bruceboge/EnviroSat/docs/raspi-image.png

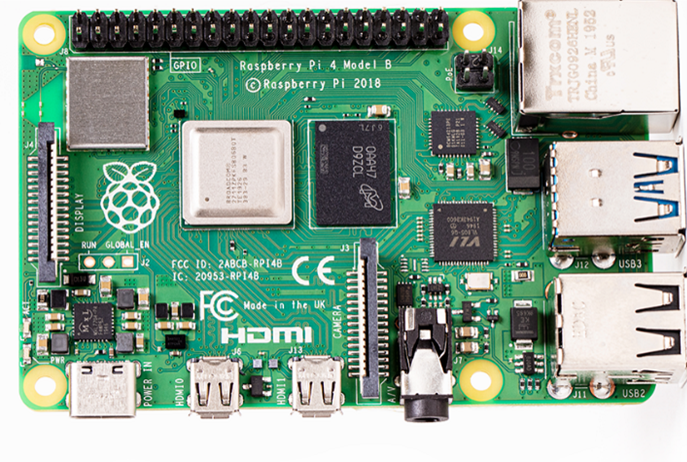
docs/raspi-image.png
