bruceboge/EnviroSat/Images/Board 2(3).png

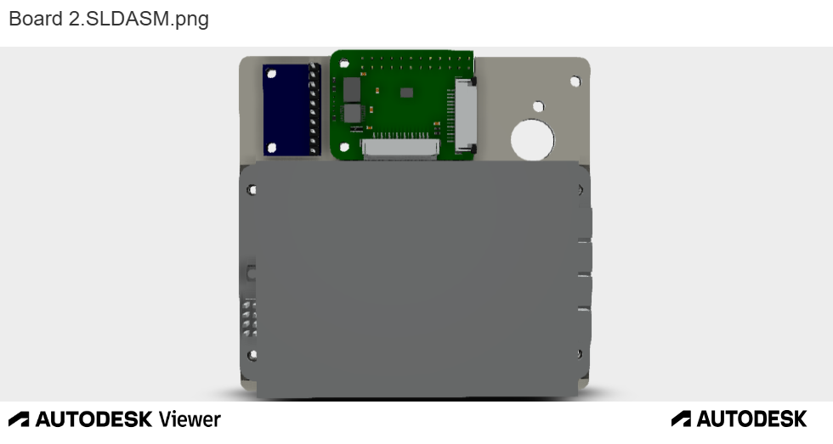
Images/Board 2(3).png
