bruceboge/EnviroSat/Images/Board 2.png

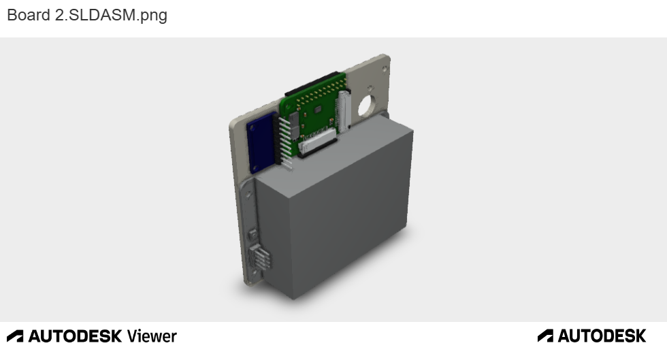
Images/Board 2.png
