bruceboge/EnviroSat/Images/Board 3.png

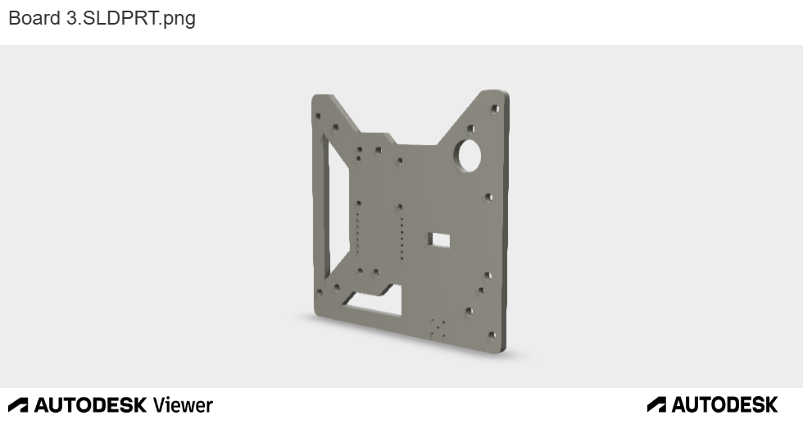
Images/Board 3.png
