bruceboge/EnviroSat/Images/powersystem.drawio.png

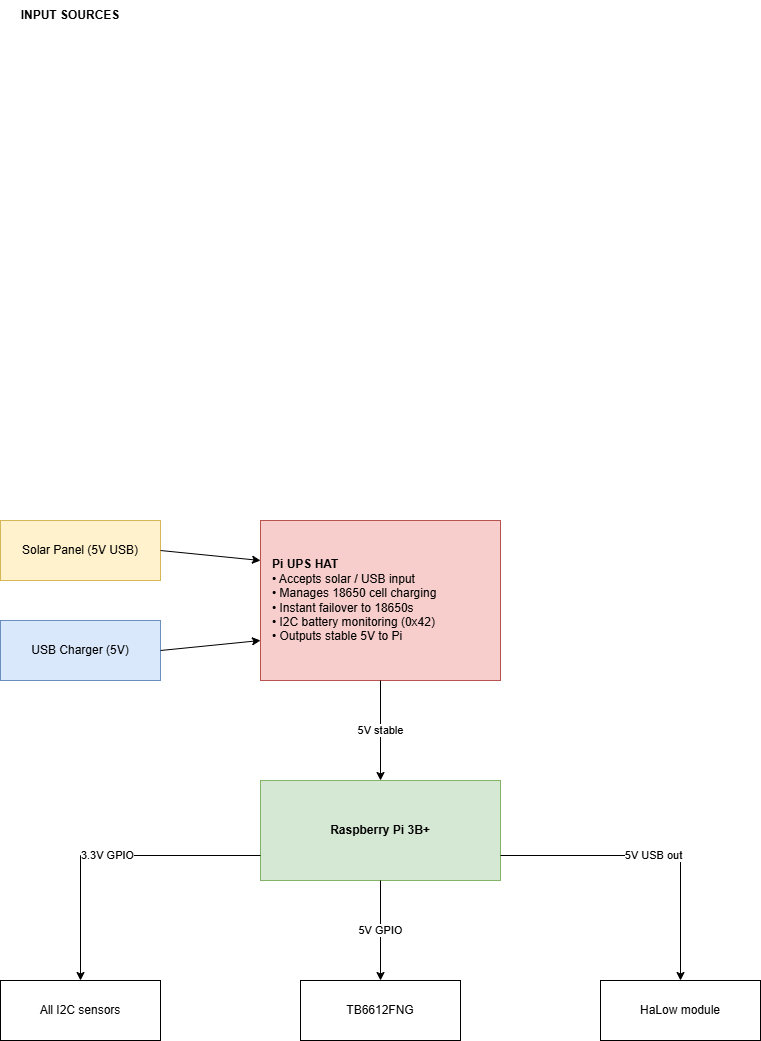
Images/powersystem.drawio.png
