bruceboge/EnviroSat/Images/Side Camera_Frame 2.png

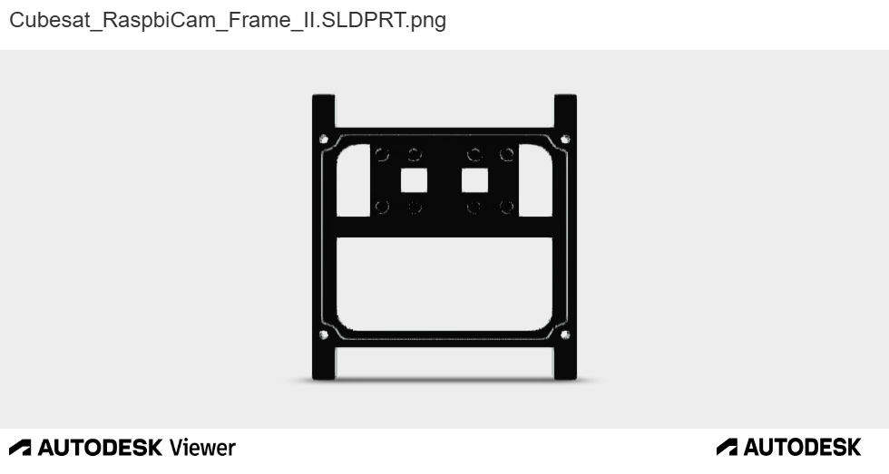
Images/Side Camera_Frame 2.png
