bruceboge/EnviroSat/Images/Side_Frame_Plain.png

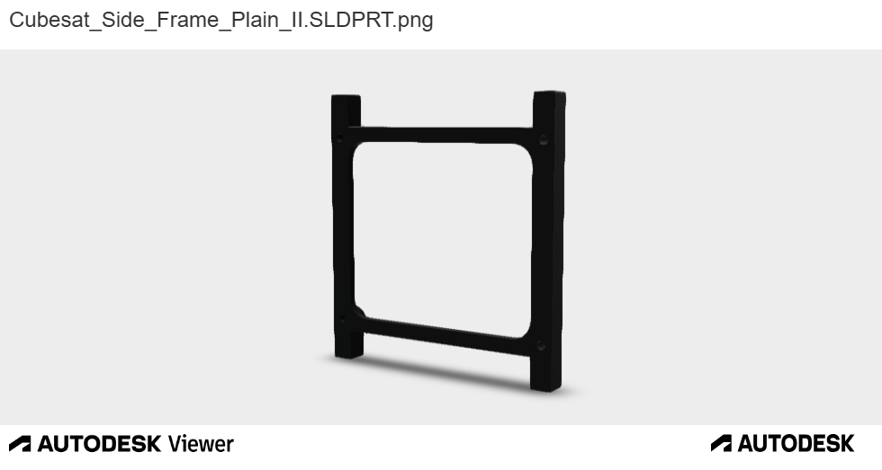
Images/Side_Frame_Plain.png
