bruceboge/EnviroSat/Images/Top_Frame.png

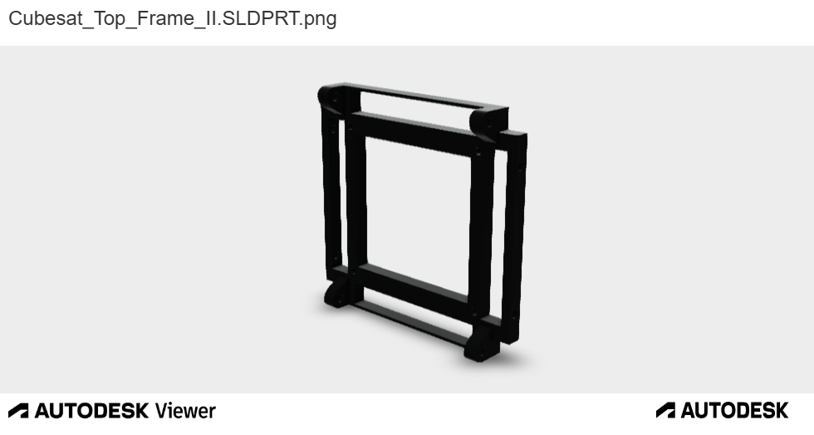
Images/Top_Frame.png
