bruceboge/EnviroSat/structure/Assembly/Cubesat.SLDASM

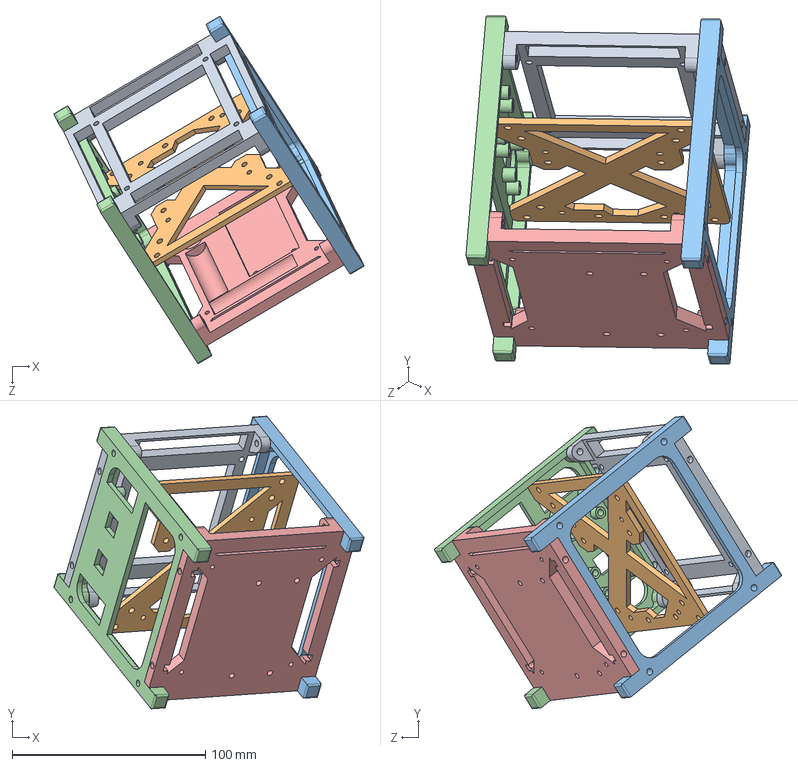
[picture p31: CAD file, 2026-03-10]
structure/Assembly/Cubesat.SLDASM
160.4 x 151.4 x 179.6 mm
Cubesat_Bottom_Frame_II
Cubesat_RaspbiCam_Frame_II
Cubesat_Side_Frame_Plain_II
Cubesat_Adaptor_Mount_II
Cubesat_Top_Frame_II
