bruceboge/EnviroSat/structure/3D Design Files/Modified_Cubesat_RaspbiCam Dual_Camera_Frame.stl

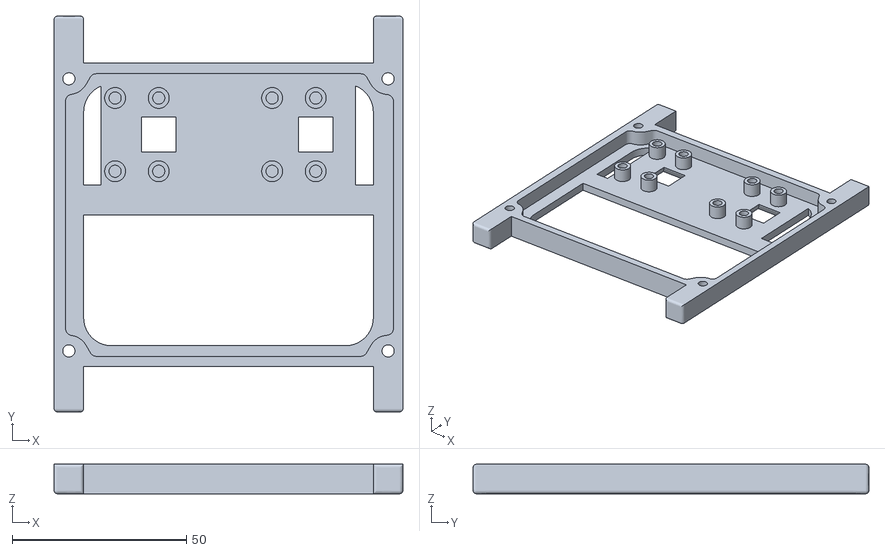
[picture p32: CAD file, 2026-03-10]
structure/3D Design Files/Modified_Cubesat_RaspbiCam Dual_Camera_Frame.stl
100.0 x 113.5 x 8.50
