bruceboge/EnviroSat/structure/3D Design Files/Cubesat_Adaptor_Mount.stl

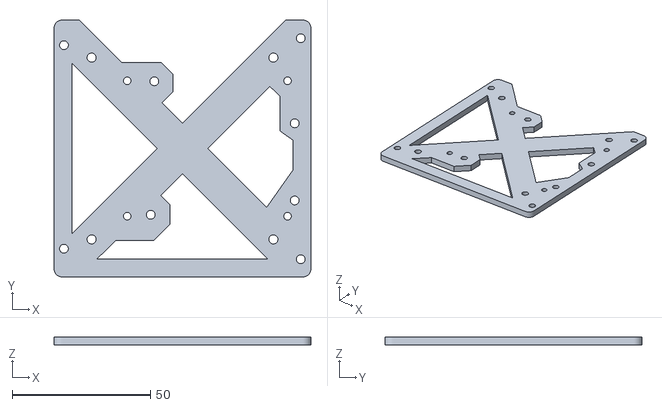
[picture p33: CAD file, 2026-03-10]
structure/3D Design Files/Cubesat_Adaptor_Mount.stl
93.0 x 93.0 x 3.00
