bruceboge/EnviroSat/structure/Assembly/Board 3.SLDPRT

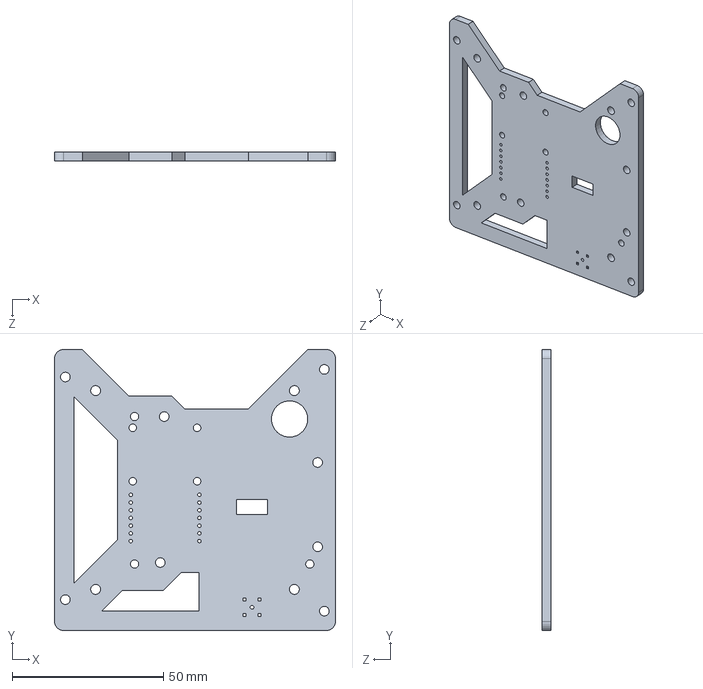
[picture p34: CAD file, 2026-03-10]
structure/Assembly/Board 3.SLDPRT
93.0 x 93.0 x 3.00 mm
