bruceboge/EnviroSat/structure/3D Design Files/Cubesat_Side_Frame_Plain.stl

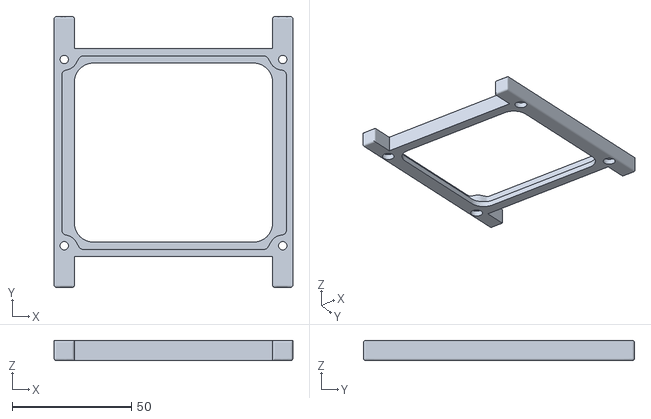
[picture p35: CAD file, 2026-03-10]
structure/3D Design Files/Cubesat_Side_Frame_Plain.stl
100.0 x 113.5 x 8.50
