bruceboge/EnviroSat/structure/Assembly/Arducam Multi Cam.SLDPRT

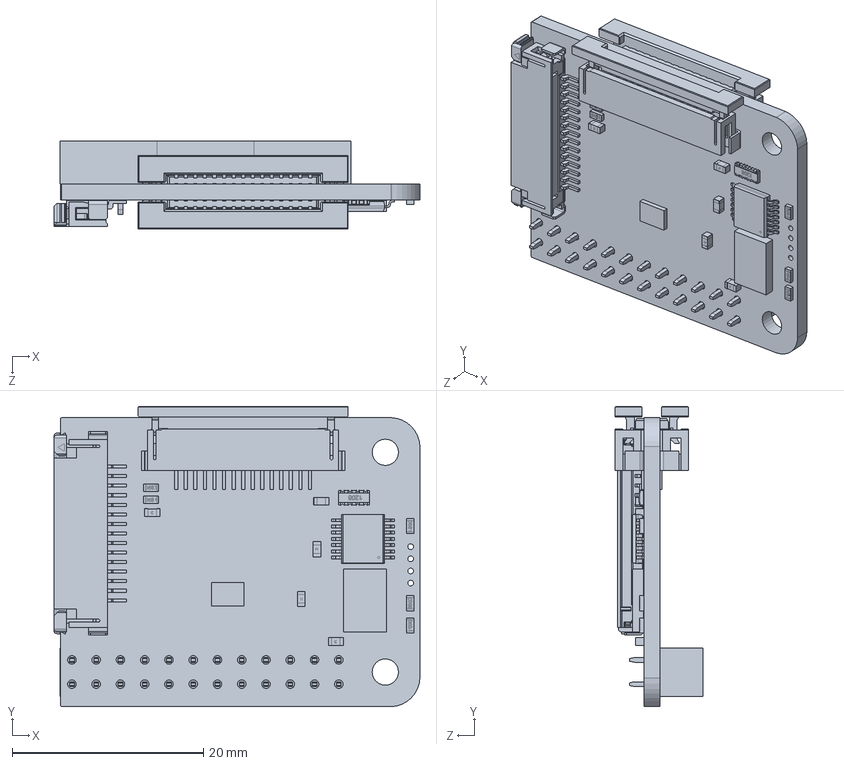
[picture p36: CAD file, 2026-03-10]
structure/Assembly/Arducam Multi Cam.SLDPRT
38.3 x 31.4 x 9.16 mm
