bruceboge/EnviroSat/structure/3D Design Files/Original_Cubesat_RaspbiCam_Frame.stl

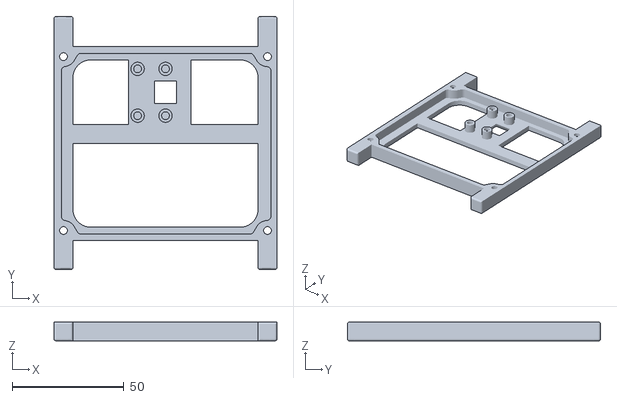
[picture p37: CAD file, 2026-03-10]
structure/3D Design Files/Original_Cubesat_RaspbiCam_Frame.stl
100.0 x 113.5 x 8.50
