bruceboge/EnviroSat/structure/Assembly/Cubesat_RaspbiCam_Frame_II.SLDPRT

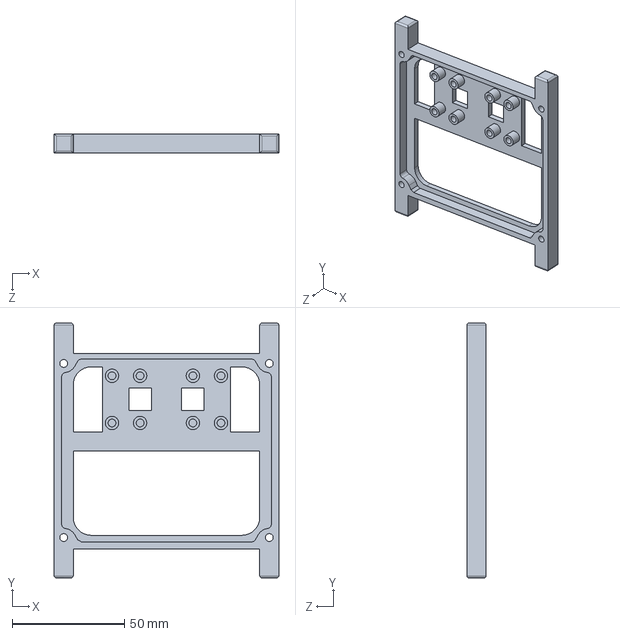
[picture p38: CAD file, 2026-03-10]
structure/Assembly/Cubesat_RaspbiCam_Frame_II.SLDPRT
100.0 x 113.5 x 8.50 mm
