bruceboge/EnviroSat/structure/Assembly/Cubesat_Top_Frame_II.SLDPRT

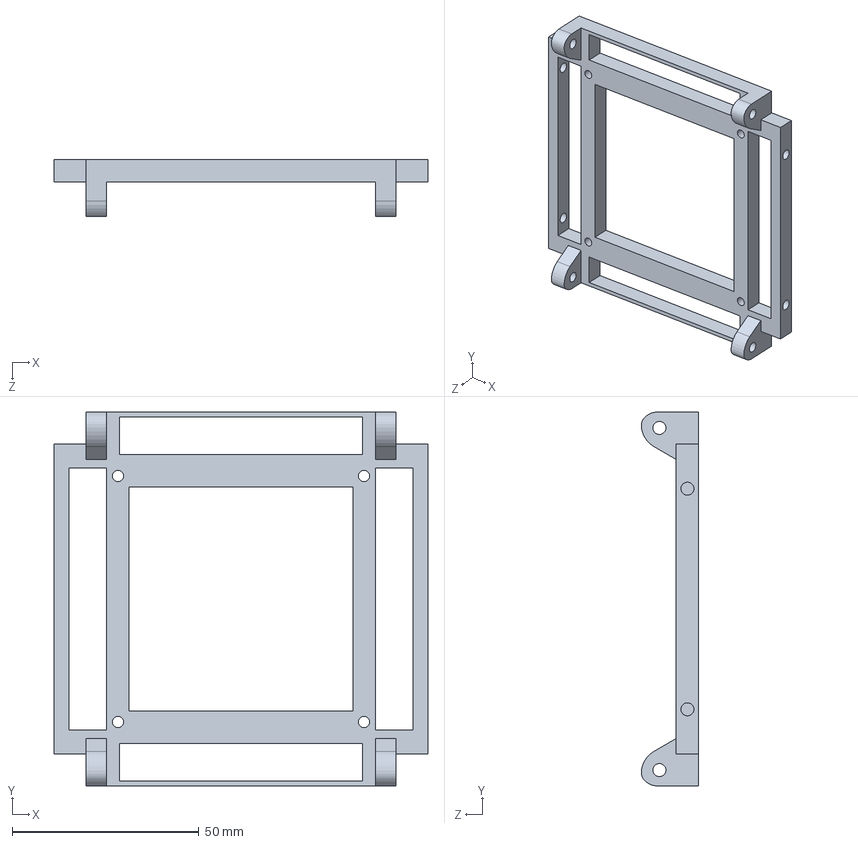
[picture p39: CAD file, 2026-03-10]
structure/Assembly/Cubesat_Top_Frame_II.SLDPRT
100.0 x 100.0 x 15.3 mm
