bruceboge/EnviroSat/structure/Assembly/Board 2.SLDPRT

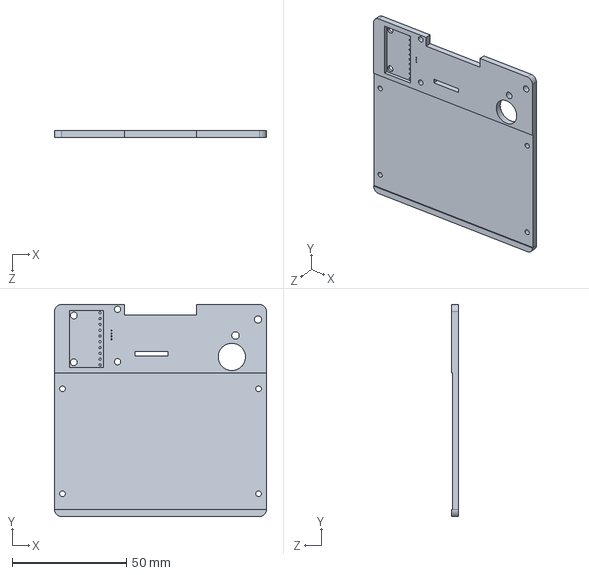
[picture p41: CAD file, 2026-03-10]
structure/Assembly/Board 2.SLDPRT
93.0 x 93.0 x 3.00 mm
