bruceboge/EnviroSat/structure/Assembly/NRF24l01_with_antenna.SLDASM

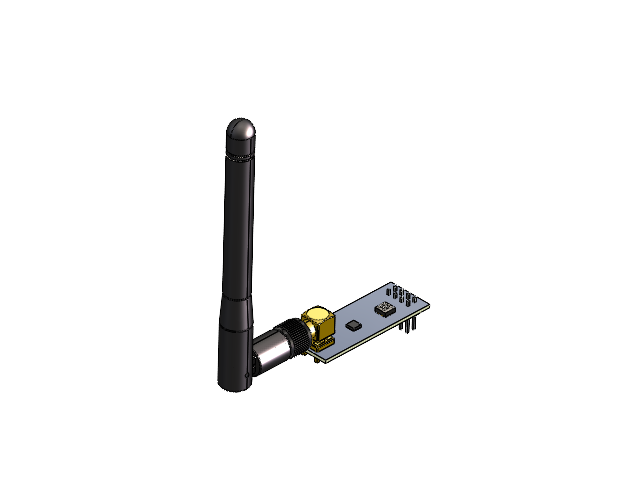
[picture p42: CAD file, 2026-03-10]
structure/Assembly/NRF24l01_with_antenna.SLDASM
User Library-QFN-16_3x3_1.STEP
User Library-QFN-16_3x3_2.STEP
User Library-QFN-16_3x3_3.STEP
User Library-QFN-16_3x3_4.STEP
User Library-QFN-16_3x3_5.STEP
User Library-QFN-16_3x3_6.STEP
User Library-QFN-16_3x3_7.STEP
User Library-QFN-16_3x3_8.STEP
User Library-QFN-16_3x3_9.STEP
User Library-QFN-16_3x3_10.STEP
User Library-QFN-16_3x3_11.STEP
User Library-QFN-16_3x3_12.STEP
User Library-QFN-16_3x3_13.STEP
User Library-QFN-16_3x3_14.STEP
User Library-QFN-16_3x3_15.STEP
User Library-QFN-16_3x3_16.STEP
User Library-QFN-16_3x3_17.STEP
User Library-QFN-16_3x3_18.STEP
Bottom_Radio_Antenna_D_faut.STEP
Top_Radio_Antenna_D_faut.STEP
Screw_Radio_Antenna_D_faut.STEP
Insert_Radio_Antenna_D_faut.STEP
Pin_Radio_Antenna_D_faut.STEP x 2
Wire_Top_Radio_Antenna_D_faut.STEP
Wire_Radio_Antenna_D_faut.STEP
NRF24L01_PCB.STEP
male header.STEP x 8
NRF24L01_SMA-angled.STEP
NRF24L01-CHIP-NRF___ _________.STEP
