bruceboge/EnviroSat/(list of files, cad)

Other CAD files:
structure/Assembly/Cubesat_Adaptor_Mount_II.SLDPRT
structure/Assembly/Cubesat_Side_Frame_Plain_II.SLDPRT
