bruceboge/EnviroSat/docs/WiFi_HaLow_Guide.docx

WiFi HaLow

Technology & Interface Guide

Heltec HT-HC01P Module with Raspberry Pi

IEEE 802.11ah • 902–928 MHz • Sub-1GHz IoT Networking

Parameter | Value
Standard | IEEE 802.11ah (WiFi HaLow)
Frequency Band | 902–928 MHz (US/AU Region)
Module | Heltec HT-HC01P
Interface | Mini PCIe → USB
Max Data Rate | 32.5 Mbps
Range | 1–2 km
Antenna | 2.6dBi SMA Male 915MHz 195mm
Host Platform | Raspberry Pi + Grove Base Hat

Revision 1.0 • 2026

# 1. What Is WiFi HaLow?

WiFi HaLow (pronounced 'halo') is the industry name for devices implementing the IEEE 802.11ah wireless standard. Unlike conventional WiFi that operates at 2.4GHz or 5GHz, WiFi HaLow works at sub-1GHz frequencies — specifically 902–928MHz in the US and Australian markets. This fundamental difference in operating frequency gives it radically different performance characteristics that make it ideal for IoT, robotics, drones, and industrial deployments.

The technology trades raw throughput for dramatically extended range, better obstacle penetration, and much lower power consumption — properties that standard WiFi simply cannot achieve at 2.4GHz or 5GHz.

## 1.1 The Simple Analogy

Think of regular WiFi as a sprinter — incredibly fast over short distances but quickly exhausted. WiFi HaLow is the marathon runner — slower peak speed but capable of covering enormous distances using far less energy. For applications that need reliable wireless connectivity across a building, campus, or kilometre-scale outdoor area, HaLow is the superior choice.

## 1.2 Why Lower Frequency Means Better Range

The physics of radio propagation favours lower frequencies for long-range communication in several ways:

- Lower frequencies lose less energy over distance — the signal travels further on the same transmit power
- Long waves bend around obstacles more effectively — a property called diffraction that increases at lower frequencies
- Sub-1GHz signals penetrate walls, floors, concrete, and dense vegetation far better than 2.4GHz
- Less interference from crowded 2.4GHz band (microwave ovens, Bluetooth, other WiFi networks)

## 1.3 WiFi HaLow vs Everything Else

Technology | Range | Speed | Power | Native IP | Best For
WiFi (2.4GHz) | 50–100m | Up to 600Mbps+ | High | Yes | Laptops, streaming
WiFi HaLow (915MHz) | 1km+ | Up to 32.5Mbps | Very Low | Yes | IoT, drones, robots
LoRa | 5–15km | <50Kbps | Extremely Low | No | Tiny sensor packets
Bluetooth | 10–30m | 3Mbps | Low | No | Personal devices
4G/LTE | 10km+ | High | Medium | Yes | Mobile broadband
Zigbee | 10–100m | 250Kbps | Very Low | No | Smart home mesh

HaLow's biggest advantage over LoRa is native IP networking. Every HaLow device gets a real IP address and runs standard TCP/UDP protocols — SSH, HTTP, MQTT, RTP video streams — exactly like regular WiFi, just over kilometre-scale distances.

# 2. How WiFi HaLow Works

WiFi HaLow uses the same fundamental architecture as regular WiFi — OFDM modulation, WPA3 security, standard 802.11 association and authentication protocols — but adapted for sub-1GHz operation with specific IoT optimisations.

## 2.1 Network Architecture

A HaLow network requires at least two devices: one Access Point (AP) and one or more Stations (STA). The AP is the hub that all stations connect through, exactly like a home router.

Role | Function | Configured As
Access Point (AP) | Hub — manages the network, routes traffic | Ground station Pi
Station (STA) | Client — connects to and communicates through the AP | Drone/robot Pi

After powering both devices, allow 1–3 minutes for the 802.11ah association process to complete — HaLow takes longer to associate than standard WiFi due to the extended channel scanning at sub-1GHz.

## 2.2 Key Technical Features

- OFDM modulation adapted for 1/2/4/8 MHz narrow channels at sub-1GHz
- WPA3 security — same encryption standard as modern WiFi
- MCS0–MCS9 modulation and coding schemes for adaptive rate vs range trade-off
- TWT (Target Wake Time) — devices negotiate wake schedules saving battery dramatically
- BSS Colouring — allows multiple HaLow networks to coexist without interference
- Up to 8,191 devices per Access Point — designed for massive IoT deployments

## 2.3 Frequency Regions

Region | LoRa/HaLow Band | This Module Compatible?
USA / Canada | 902–928 MHz (US915) | Yes
Australia | 915–928 MHz (AU915) | Yes
Europe | 863–870 MHz (EU868) | No — need 868MHz variant
Asia (Japan/Korea) | 916.5–927.5 MHz (AS923) | Check local variant

# 3. Heltec HT-HC01P Module

The HT-HC01P is Heltec Automation's WiFi HaLow module in Mini PCIe form factor. It uses the Morse Micro MM6108IQ chipset — one of the leading 802.11ah implementations — and includes an onboard PA (Power Amplifier), high-linearity LNA (Low Noise Amplifier), T/R switch, and 32MHz crystal oscillator.

## 3.1 Module Specifications

Parameter | Value
Chipset | Morse Micro MM6108IQ
Standard | IEEE 802.11ah (WiFi HaLow)
Power Supply | 3.3V
Frequency Band | 902–928 MHz
Channel Bandwidth | 1 / 2 / 4 / 8 MHz (configurable)
Maximum Data Rate | 32.5 Mbps @ 8MHz channel
Transmission Range | 1–2 km line of sight
Form Factor | Mini PCIe (52-pin)
Dimensions | 50.95 × 30.00 × 3.75 mm
Antenna Connector | U.FL (I-PEX) on-module
Interface to Host | USB 2.0 via Mini PCIe USB pins
Sleep/Hibernate | Low-power hibernate with internal/external wake
Security | WPA2/WPA3, IEEE 802.11i

## 3.2 The Debug Board

The HT-HC01P Debug Board is a companion breakout PCB specifically designed for the HC01P module. It cleanly exposes the USB interface, power supply, and programming/debug connections without requiring jumper wires. Key features:

- Mini PCIe slot to accept the HC01P module — secured with M2 retention screw
- USB output connector — routes Mini PCIe USB pins to standard USB-A port
- Onboard 3.3V regulator — powers module from 5V USB bus automatically
- Debug/UART header — for firmware updates and serial console access
- Power LED and status indicators
- No jumper configuration required — clean, production-ready interface

# 4. Antenna — 2.6dBi 915MHz SMA

## 4.1 Antenna Specifications

Specification | Value
Gain | 2.6 dBi
Frequency | 902–928 MHz
Length | 195 mm
Connector | SMA Male (center pin, internal threads)
Impedance | 50Ω
Polarization | Vertical, omnidirectional
Radiation Pattern | 360° horizontal coverage

## 4.2 SMA vs RP-SMA — Critical Distinction

The single most common wiring mistake with RF antennas is confusing SMA and RP-SMA connectors. They look nearly identical but are NOT interchangeable.

Connector | Center Contact | Threads | Used For
SMA Male (this antenna) | CENTER PIN present | Internal | LoRa, GPS, Cellular, HaLow
SMA Female (module port) | Center socket | External | Module RF ports
RP-SMA Male | Center socket/hole | External | WiFi routers (2.4GHz)
RP-SMA Female | Center pin | Internal | WiFi access points

The HT-HC01P module has a U.FL (I-PEX) micro connector on the PCB — not a full SMA port. A pigtail adapter cable is required to connect the SMA antenna to the module.

## 4.3 Antenna Connection Chain

Step | Component | Connector Type | Notes
1 | 2.6dBi SMA Antenna | SMA Male plug | The antenna itself
2 | Pigtail cable (female end) | SMA Female socket | Screws onto antenna
3 | Pigtail cable (U.FL end) | U.FL snap connector | Snaps onto module
4 | HT-HC01P module | U.FL port on PCB | Press straight down to click

Required pigtail: SMA Female to U.FL/I-PEX, approximately 15cm length. Use low-loss cable type (RG316 or equivalent). Keep it as short as possible — every centimetre of cable introduces signal loss.

# 5. Complete System Architecture

The following diagram shows how all components connect in a typical ground station / drone or robot deployment:

## 5.1 Ground Station Stack

Layer | Component | Connection | Notes
Antenna | 2.6dBi 915MHz SMA | SMA Male → pigtail → U.FL | Mount vertically, away from metal
HaLow Module | HT-HC01P | Mini PCIe slot on Debug Board | Secure with M2 screw
Debug Board | HT-HC01P Debug Board | USB output cable | Powers + interfaces module
USB Adapter | Mini PCIe to USB | USB-A → Pi USB port | Bridges Mini PCIe to Pi
Host Computer | Raspberry Pi | 40-pin GPIO header | Runs HaLow network stack
Sensors | Grove Base Hat | Stacks on Pi GPIO | All Grove sensors

## 5.2 Drone / Robot Stack

The drone/robot side uses an identical hardware stack — same module, same debug board, same antenna — configured as a WiFi HaLow Station (STA) instead of Access Point (AP).

Component | Ground Station Role | Drone/Robot Role
HT-HC01P Module | Access Point (AP) | Station (STA)
IP Address | 192.168.1.1 (static) | 192.168.1.x (DHCP)
Routing | Routes traffic to internet/network | Connects through AP
Configuration | /etc/hostapd/hostapd.conf | /etc/wpa_supplicant/wpa_supplicant.conf

# 6. GPIO & Pin Reference

Because the HT-HC01P connects via USB (through the Debug Board and Mini PCIe to USB adapter), it does NOT occupy any GPIO pins on the Raspberry Pi. All 40 GPIO pins remain available for the Grove Base Hat and other peripherals.

## 6.1 Grove Base Hat — I2C Ports (for other sensors)

Grove Pin | Wire Colour | Signal | GPIO (BCM) | Physical Pin
Pin 1 | Yellow | SDA | GPIO 2 | Pin 3
Pin 2 | White | SCL | GPIO 3 | Pin 5
Pin 3 | Red | VCC (3.3V) | 3.3V | Pin 1
Pin 4 | Black | GND | GND | Pin 6

## 6.2 Grove Base Hat — UART Port (GPS sensor)

Grove Pin | Wire Colour | Signal | GPIO (BCM) | Physical Pin | Use
Pin 1 | Yellow | TX (Pi transmits) | GPIO 14 | Pin 8 | Pi TX → GPS RX
Pin 2 | White | RX (Pi receives) | GPIO 15 | Pin 10 | GPS TX → Pi RX
Pin 3 | Red | VCC (3.3V) | 3.3V | Pin 1 | Power
Pin 4 | Black | GND | GND | Pin 6 | Ground

## 6.3 GPIO Pins NOT Used by HaLow (HT-HC01P)

Unlike the ALFA AHPI7292S HAT which uses SPI and occupies many GPIO pins, the HT-HC01P + Debug Board + USB Adapter combination uses only the Pi's USB bus. Zero GPIO pins are consumed. The complete Grove Base Hat sensor ecosystem operates entirely without conflict.

# 7. Complete Wiring Summary

From | To | Cable / Method | Critical Notes
SMA Antenna (Male) | Pigtail SMA Female | Direct screw — finger tight | Do NOT use tools — over-tightening damages SMA
Pigtail U.FL end | HT-HC01P U.FL port | Snap straight down | Press perfectly vertical — U.FL is fragile
HT-HC01P module | Debug Board Mini PCIe slot | Insert at 30°, press flat, screw M2 | Secure screw prevents poor contact
Debug Board USB | Mini PCIe USB Adapter | USB-A to USB-A cable | Standard USB 2.0 cable
Mini PCIe USB Adapter | Raspberry Pi USB port | USB-A cable | Use powered hub if Pi USB insufficient
External motor battery | L293D / TB6612 VM | Direct terminals | Separate from Pi power
Pi GND | Motor driver GND | Jumper wire | Shared ground — CRITICAL
Grove Base Hat | Raspberry Pi GPIO | 40-pin HAT press-fit | Align Pin 1 carefully
Grove I2C cable | MPU-9250/6500 | Grove 4-pin to any I2C port | Any of 3 I2C ports on hat
Grove UART cable | NEO-M8N GPS | Grove 4-pin to UART port | TX/RX are crossed — Pi TX→GPS RX

# 8. Software Setup

## 8.1 Prerequisites

Step | Command | Purpose
Update system | sudo apt-get update && sudo apt-get upgrade -y | Ensure latest packages
Install tools | sudo apt-get install -y build-essential git libssl-dev iw net-tools usbutils | Build and network tools
Verify USB device | lsusb | Confirm HC01P detected
Check interface | ip link show | Confirm wlan0/halow0 created

## 8.2 Morse Micro Driver Installation

The HT-HC01P uses the Morse Micro MM6108 chipset which requires the Morse Micro Linux driver:

Step | Command
Clone driver | git clone https://github.com/MorseMicro/morse_driver.git
Build | cd morse_driver && make
Install | sudo make install
Load module | sudo modprobe morse
Auto-load on boot | echo 'morse' | sudo tee -a /etc/modules

## 8.3 Access Point Configuration (Ground Station)

Parameter | Value | Notes
interface | wlan0 | HaLow interface name
driver | nl80211 | Linux wireless driver
ssid | HaLow_Link | Network name — customise
hw_mode | ah | 802.11ah mode — mandatory
country_code | US | Set to your region
freq | 917 | Center frequency in MHz
wpa | 2 | WPA2 security
wpa_passphrase | yourpassword | Minimum 8 characters

## 8.4 Station Configuration (Drone/Robot)

The station Pi connects to the AP using wpa_supplicant. The SSID and password must exactly match the AP configuration. Allow 1–3 minutes after boot for the HaLow association to complete — this is normal and expected behaviour.

## 8.5 Verify Link Quality

Command | What It Shows
iwconfig wlan0 | Basic link status, SSID, signal level
iw dev wlan0 link | Detailed connection — TX/RX rate, signal dBm
iw dev wlan0 station dump | All connected stations (on AP)
ping 192.168.1.1 | Round-trip latency to AP
iperf3 -c 192.168.1.1 | Throughput benchmark

# 9. Troubleshooting

Problem | Likely Cause | Fix
USB device not detected | Power insufficient or cable fault | Try powered USB hub; try different cable
No wlan0/halow0 interface | Driver not installed | Install Morse Micro driver, run sudo modprobe morse
Modules won't associate | Normal — HaLow takes time | Wait 1–3 minutes after both devices boot
Poor range | Antenna orientation or connection | Ensure antenna vertical; check U.FL fully clicked
U.FL connector won't click | Alignment off | Press perfectly straight down — never at an angle
SMA antenna won't fit | Wrong connector type | Verify SMA (center pin) vs RP-SMA (center hole)
No signal at all | Frequency mismatch | Confirm both devices set to same country/frequency
Pi reboots when modules start | Motor current spike | Use separate battery for motors — not Pi USB
GPS no NMEA output | Serial console conflict | Disable serial login shell in raspi-config
I2C device not found | I2C disabled | Enable I2C in raspi-config, reboot, run i2cdetect -y 1

# 10. Key Notes & Best Practices

- Always attach the antenna BEFORE powering the HT-HC01P module — transmitting without an antenna damages the RF frontend
- The HT-HC01P connects via USB only — zero GPIO pins are consumed, all Grove ports remain free
- You need TWO complete HaLow setups for a working link — one AP, one STA
- HaLow association takes 1–3 minutes — this is normal, not a fault
- Keep the SMA-to-U.FL pigtail cable as short as possible to minimise signal loss
- Mount the antenna vertically for best omnidirectional coverage — avoid metal surfaces nearby
- The 915MHz band is US/Australia only — EU users must use the 868MHz variant
- HaLow is native IP — once connected, the drone/robot Pi is on the network exactly like regular WiFi
- Always share GND between Pi, motor drivers, and all power supplies
- U.FL connectors are rated for ~30 mating cycles — minimise plugging and unplugging

# 11. Reference Sources

Resource | URL
Heltec HT-HC01P Wiki | https://wiki.heltec.org/docs/devices/wifi-halow/hc01p/
Heltec HT-HC01P Datasheet | https://resource.heltec.cn/download/HT-HC01P/Datasheet/HT-HC01P_Rev.1.0.0.pdf
Morse Micro MM6108 SDK | https://github.com/MorseMicro
Seeed Grove Base Hat Wiki | https://wiki.seeedstudio.com/Grove_Base_Hat_for_Raspberry_Pi/
WiFi HaLow IEEE 802.11ah Overview | https://www.wi-fi.org/discover-wi-fi/wi-fi-certified-halow
SparkFun — SMA Connector Guide | https://learn.sparkfun.com/tutorials/connector-basics/sma-antenna-connectors
Raspberry Pi UART Documentation | https://www.raspberrypi.com/documentation/computers/configuration.html#configure-uarts
u-blox NEO-M8 Hardware Manual | https://content.u-blox.com/sites/default/files/NEO-M8_HardwareIntegrationManual_(UBX-13003557).pdf

Confidential — Internal Use Only Page

WiFi HaLow Technology & Interface Guide | Heltec HT-HC01P
