bruceboge/EnviroSat/Images/System wiring Guide.png

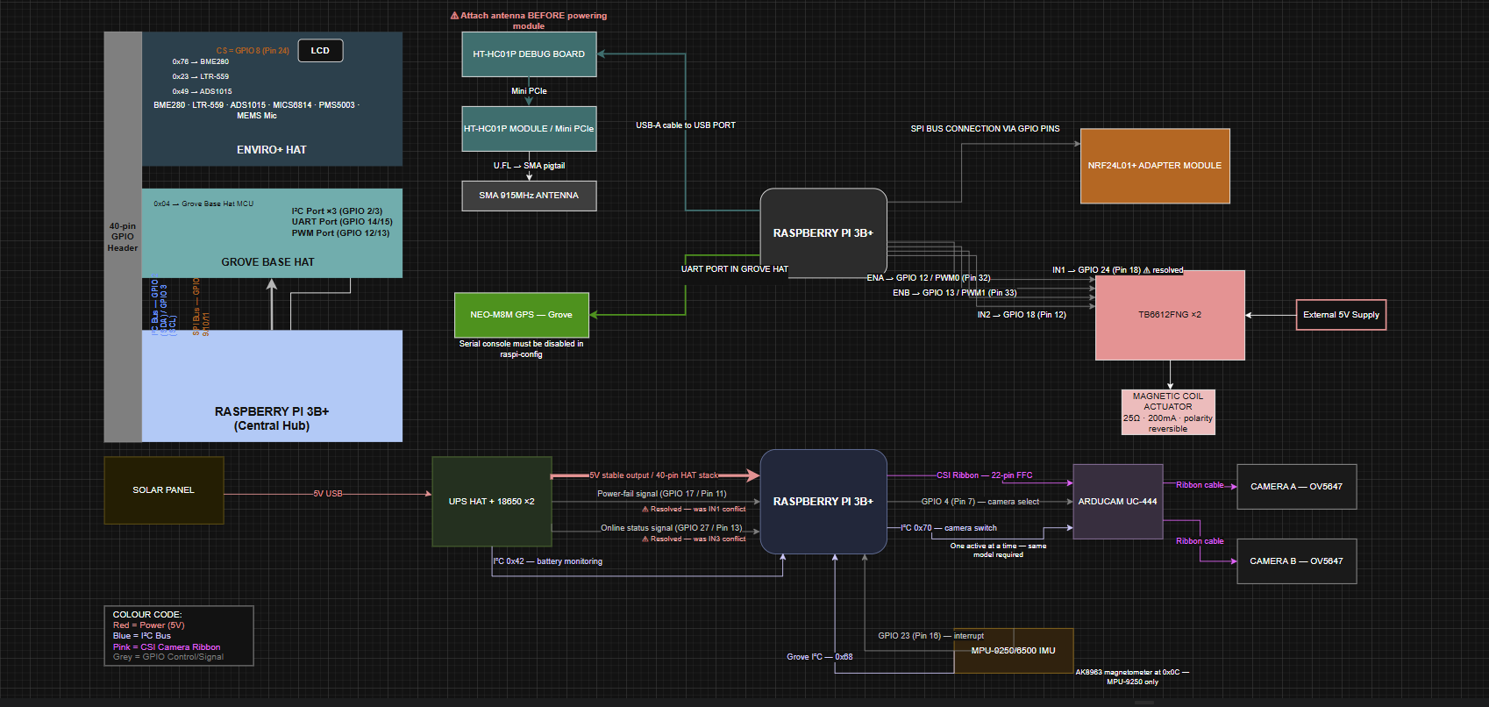
Images/System wiring Guide.png
